3WILDERCAR/Proyecto_Micro/README.md

# Proyecto_Micro
Aqui se va a subir todo lo que se vaya a programar
