3WILDERCAR/Proyecto_Micro/Archivos KiCAD/Green_Card.kicad_sch

## KiCad design Archivos KiCAD/Green_Card.kicad_sch (2026-10-22)

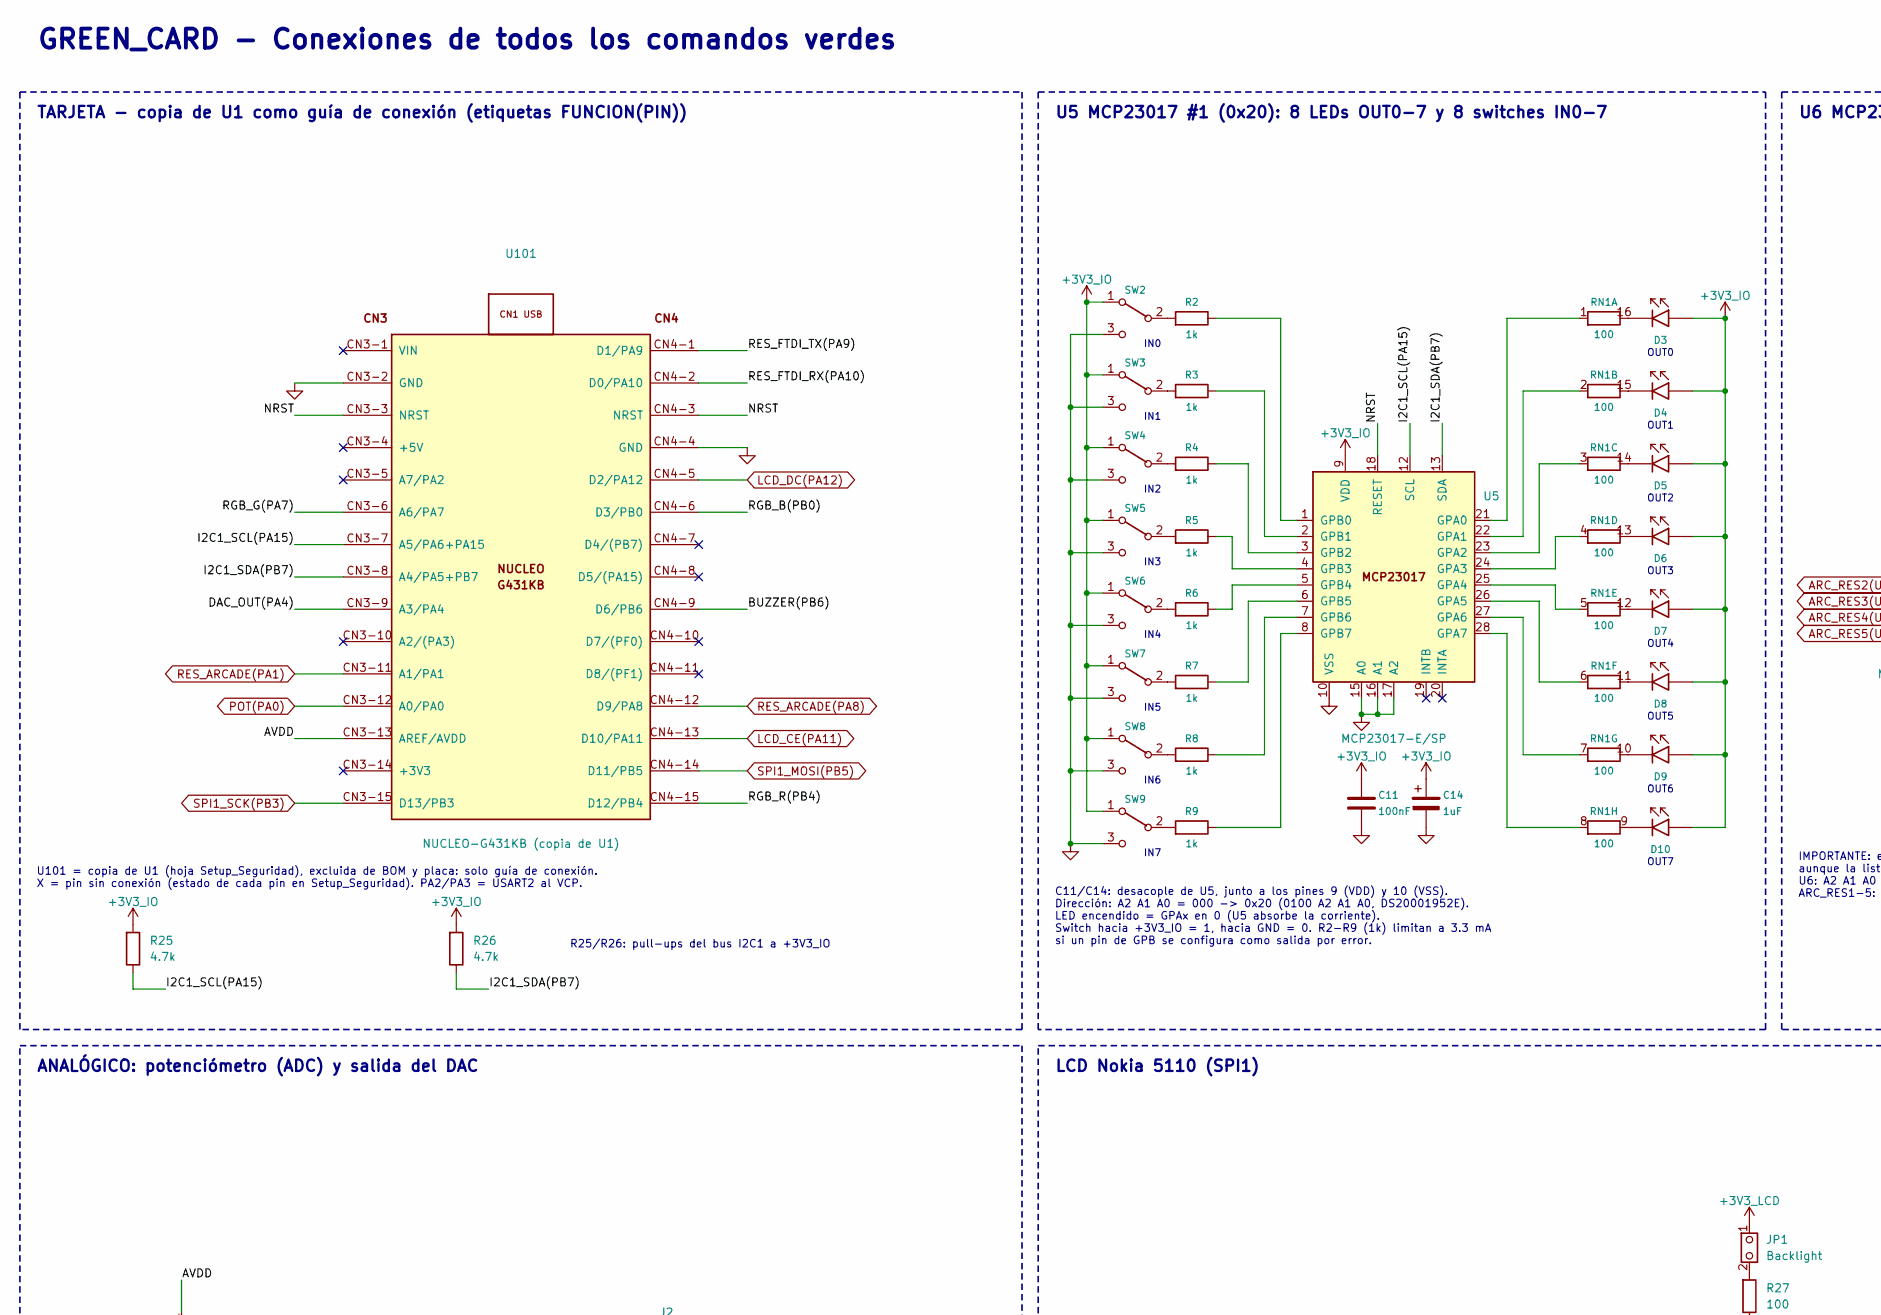
[picture p1: schematic Green_Card.kicad_sch, part in row 1, column 1]

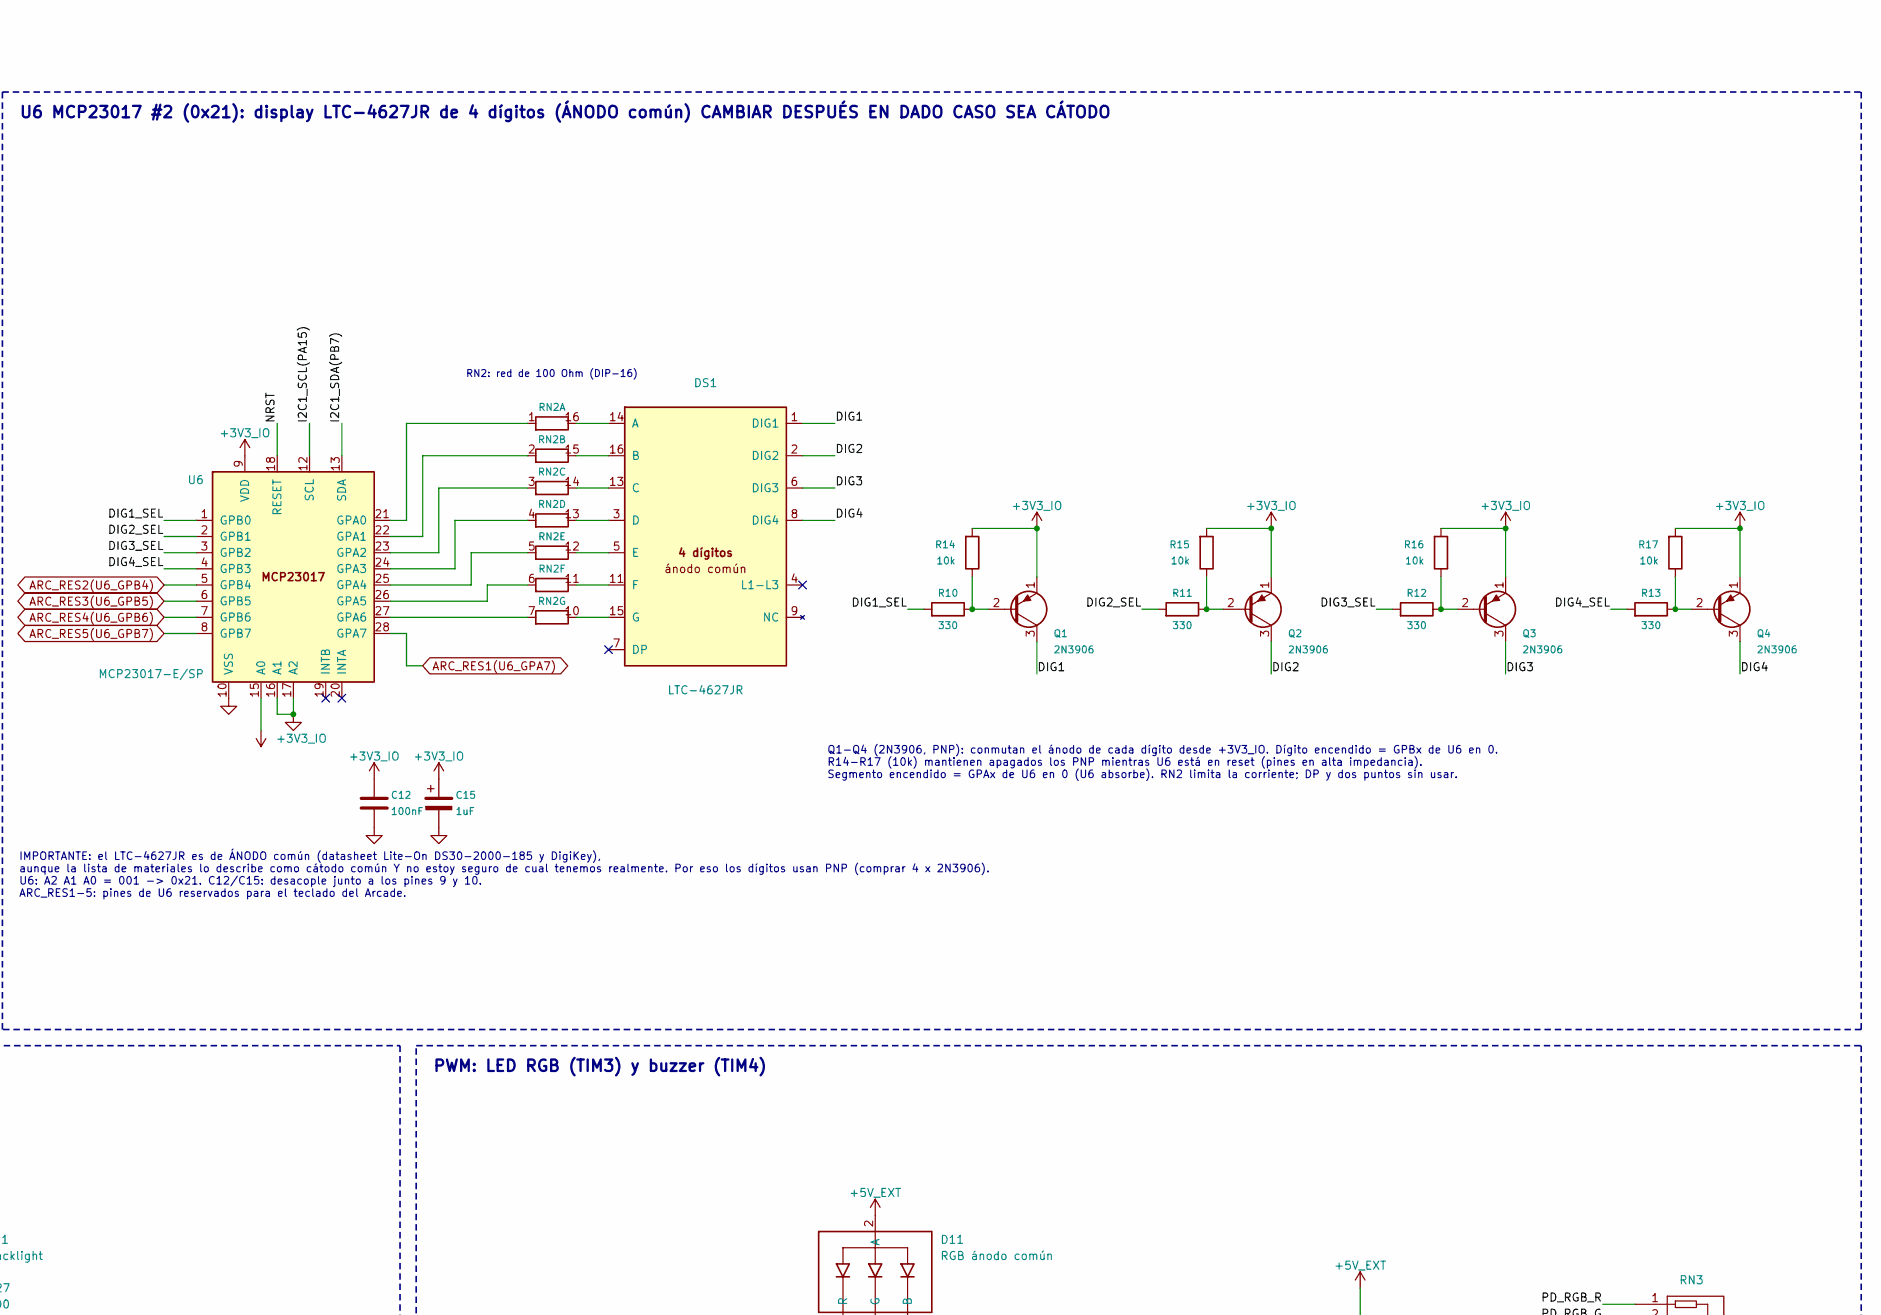
[picture p2: schematic Green_Card.kicad_sch, part in row 1, column 2]

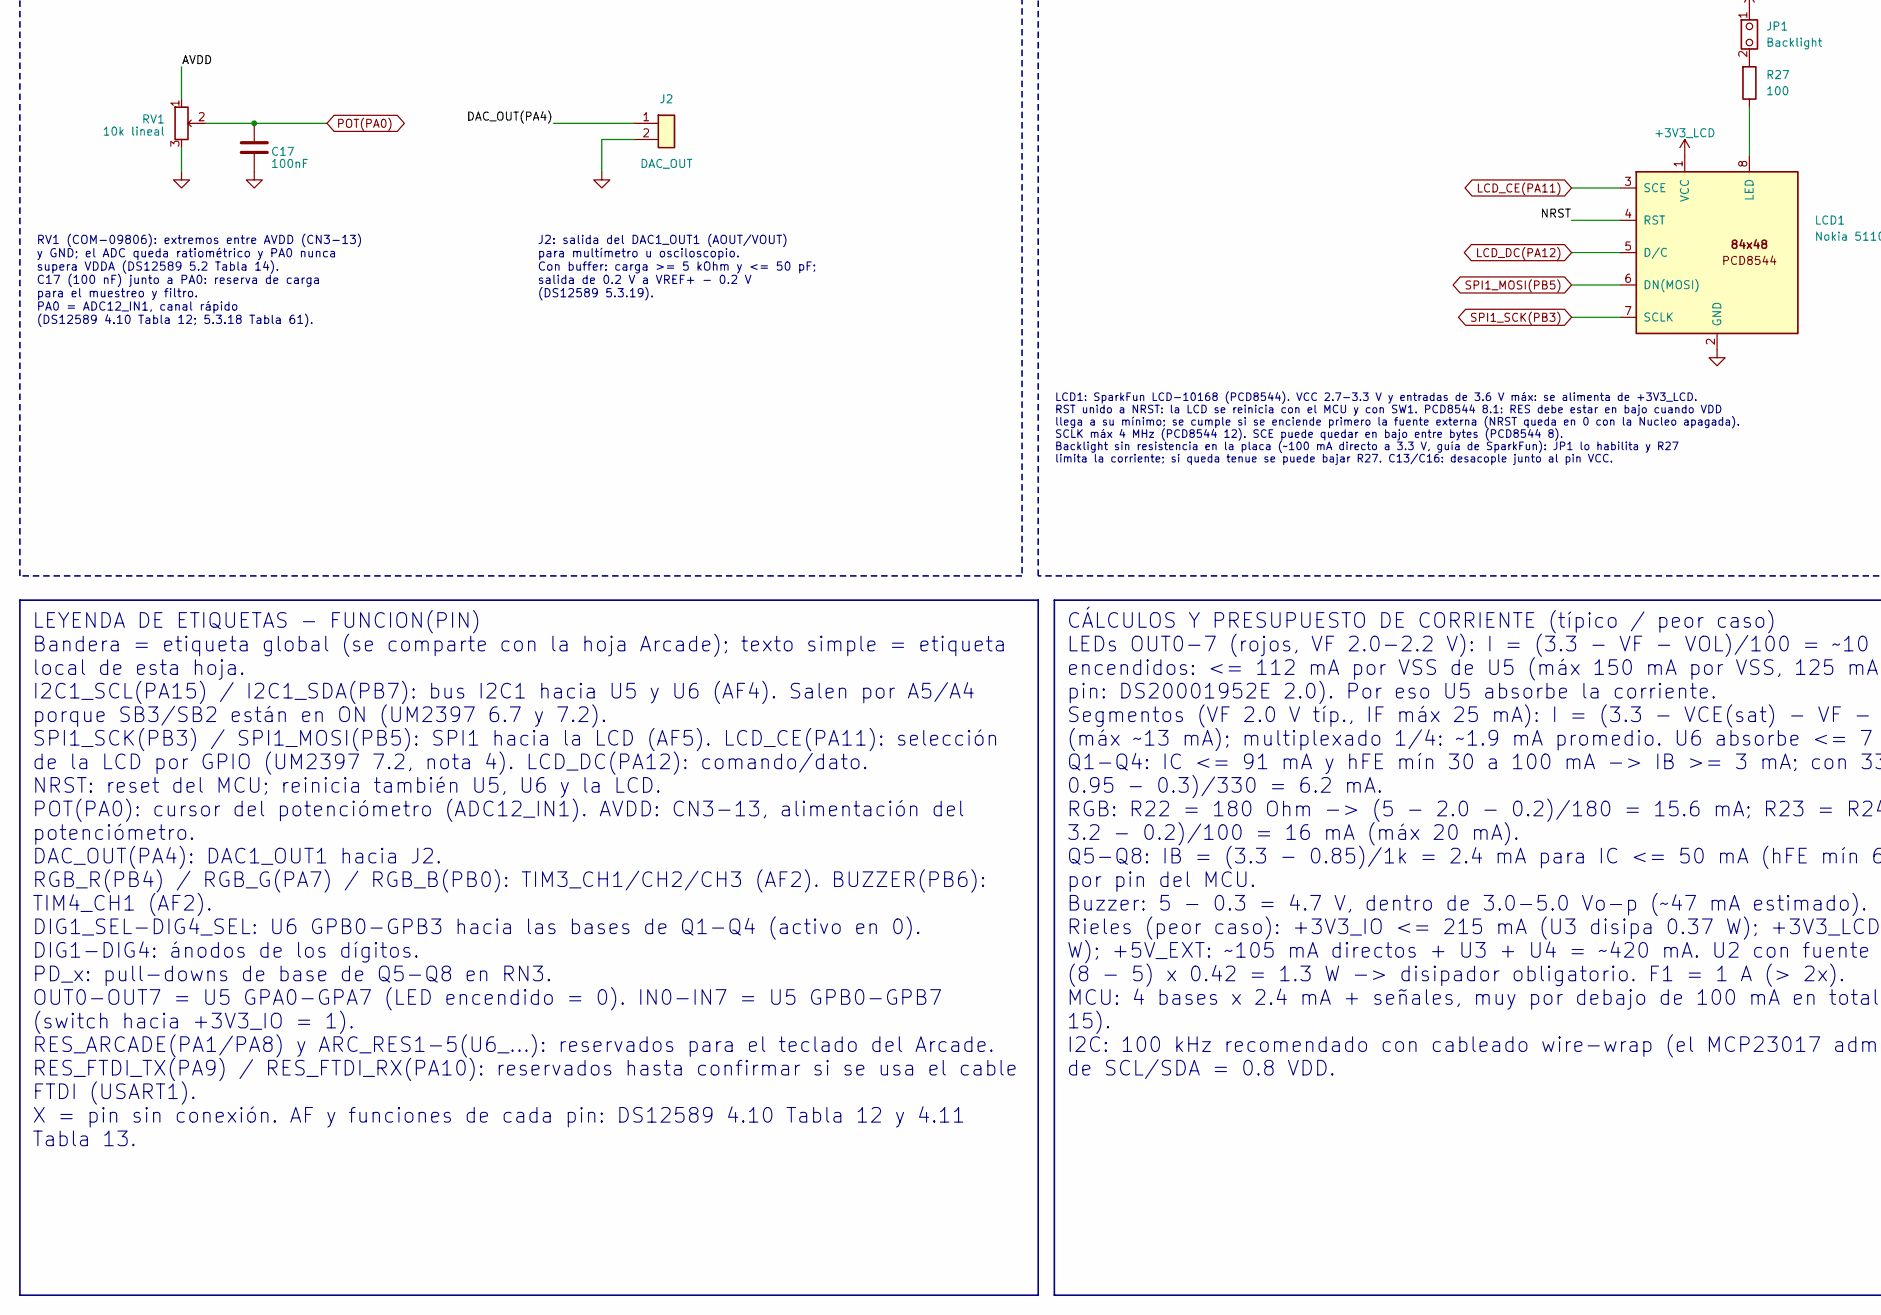
[picture p3: schematic Green_Card.kicad_sch, part in row 2, column 1]

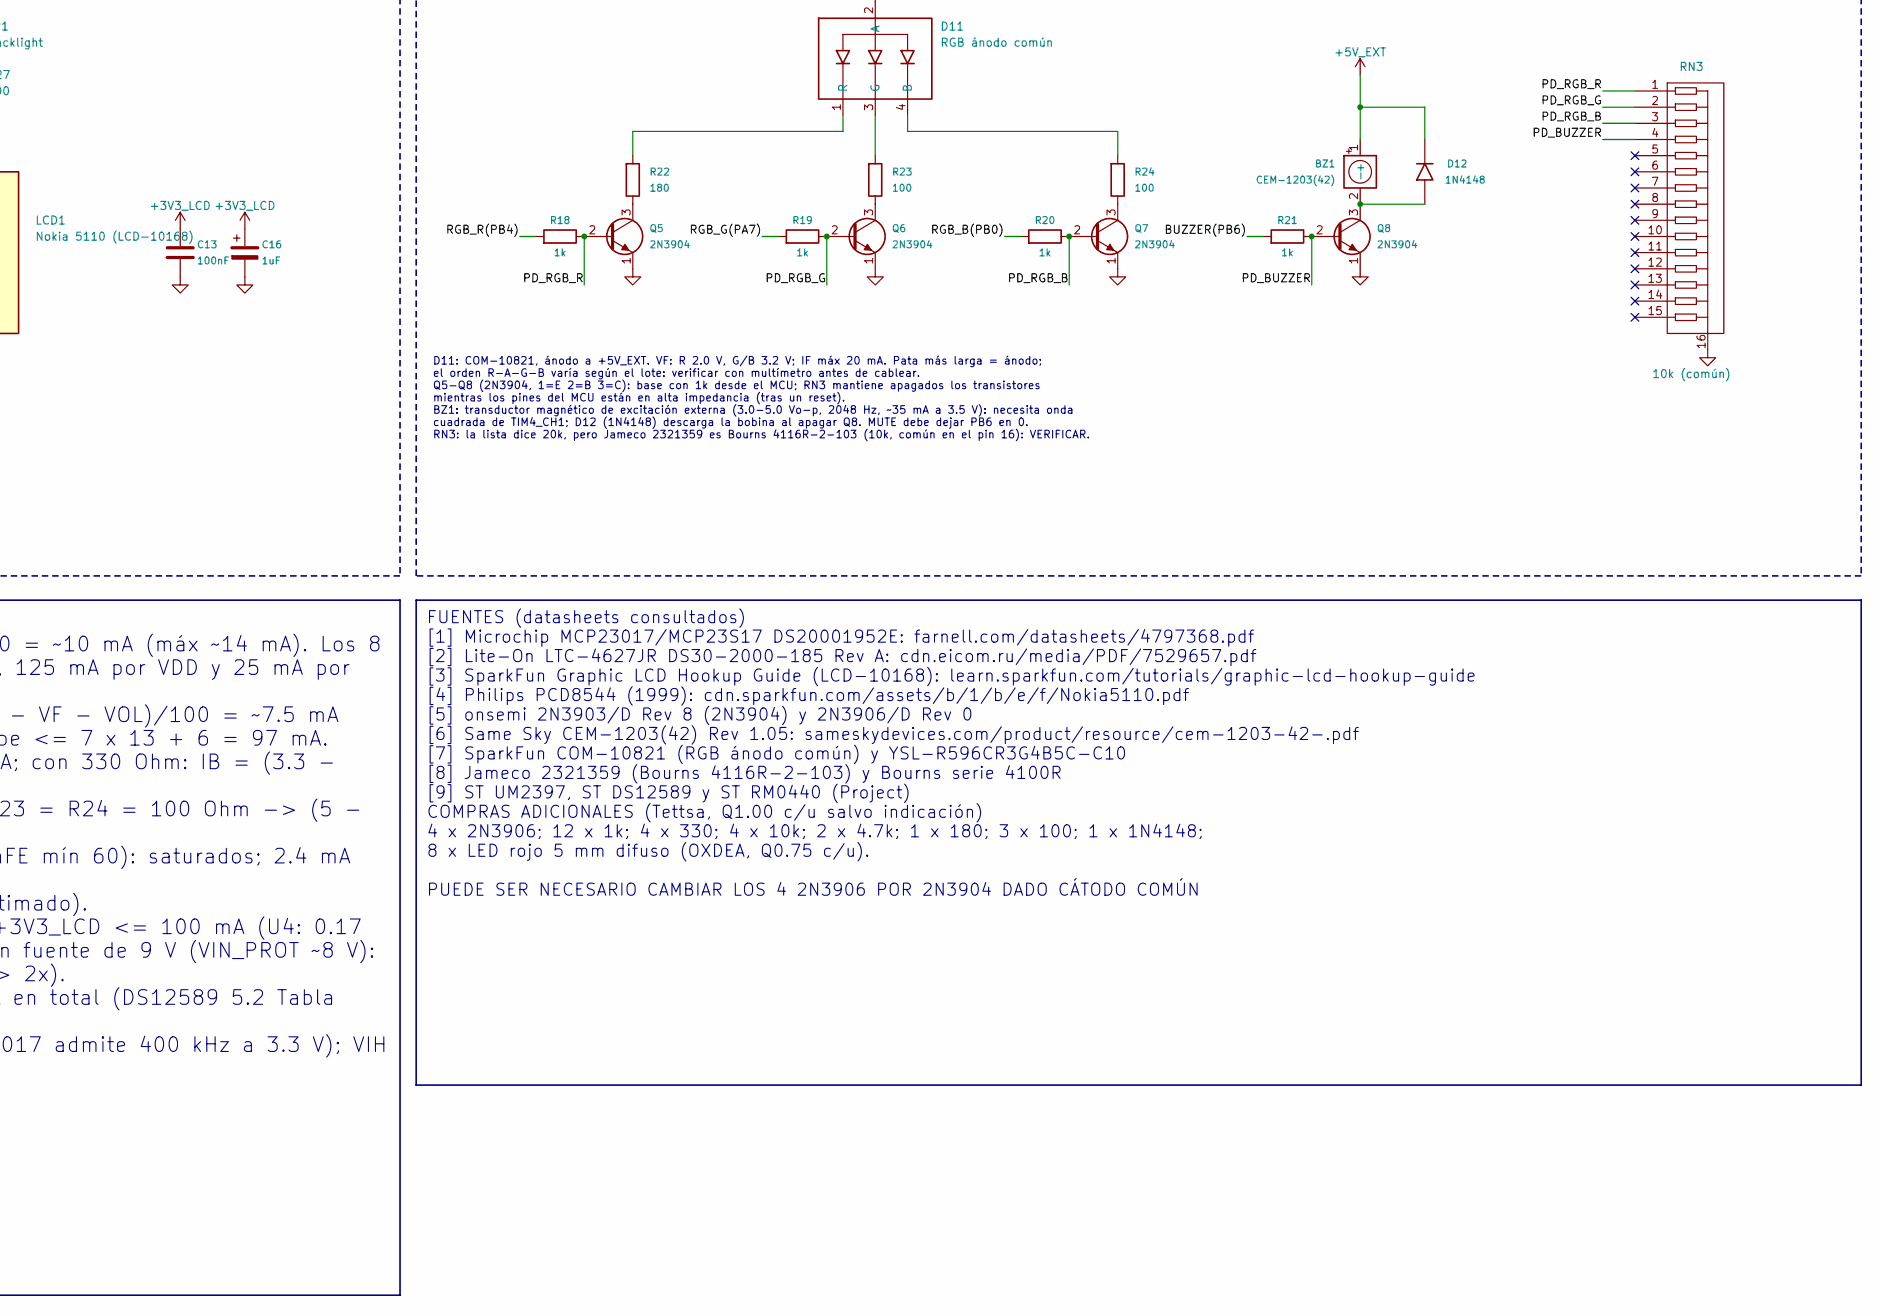
[picture p4: schematic Green_Card.kicad_sch, part in row 2, column 2]

Parts:
BZ1: CEM-1203(42)
C11, C12, C13, C17: 100nF
C14, C15, C16: 1uF
D3, D4, D5, D6, D7, D8, D9, D10: Rojo 5mm
D11: RGB ánodo común
D12: 1N4148
DS1: LTC-4627JR
J2: DAC_OUT
JP1: Backlight
LCD1: Nokia 5110 (LCD-10168)
Q1, Q2, Q3, Q4: 2N3906
Q5, Q6, Q7, Q8: 2N3904
R2, R3, R4, R5, R6, R7, R8, R9, R18, R19, R20, R21: 1k
R10, R11, R12, R13: 330
R14, R15, R16, R17: 10k
R22: 180
R23, R24, R27: 100
R25, R26: 4.7k
RN1, RN2: 100
RN3: 10k (común)
RV1: 10k lineal
SW2, SW3, SW4, SW5, SW6, SW7, SW8, SW9: SPDT
U5, U6: MCP23017-E/SP
U101: NUCLEO-G431KB (copia de U1)

Connections:
+3V3_IO: C11.1, C12.1, C14.1 (+), C15.1 (+), D3.2 (A), D4.2 (A), D5.2 (A), D6.2 (A), D7.2 (A), D8.2 (A), D9.2 (A), D10.2 (A), Q1.1 (E), Q2.1 (E), Q3.1 (E), Q4.1 (E), R14.1, R15.1, R16.1, R17.1, R25.1, R26.1, SW2.1, SW3.1, SW4.1, SW5.1, SW6.1, SW7.1, SW8.1, SW9.1, U5.9 (VDD), U6.9 (VDD), U6.15 (A0)
+3V3_LCD: C13.1, C16.1 (+), JP1.1, LCD1.1 (VCC)
+5V_EXT: BZ1.1 (+), D11.2 (A), D12.1 (K)
ARC_RES1(U6_GPA7): U6.28 (GPA7)
ARC_RES2(U6_GPB4): U6.5 (GPB4)
ARC_RES3(U6_GPB5): U6.6 (GPB5)
ARC_RES4(U6_GPB6): U6.7 (GPB6)
ARC_RES5(U6_GPB7): U6.8 (GPB7)
AVDD: RV1.1, U101.CN3-13 (AREF/AVDD)
BUZZER(PB6): R21.1, U101.CN4-9 (D6/PB6)
DAC_OUT(PA4): J2.1, U101.CN3-9 (A3/PA4)
DIG1: DS1.1 (DIG1), Q1.3 (C)
DIG1_SEL: R10.1, U6.1 (GPB0)
DIG2: DS1.2 (DIG2), Q2.3 (C)
DIG2_SEL: R11.1, U6.2 (GPB1)
DIG3: DS1.6 (DIG3), Q3.3 (C)
DIG3_SEL: R12.1, U6.3 (GPB2)
DIG4: DS1.8 (DIG4), Q4.3 (C)
DIG4_SEL: R13.1, U6.4 (GPB3)
GND: C11.2, C12.2, C13.2, C14.2 (-), C15.2 (-), C16.2 (-), C17.2, J2.2, LCD1.2 (GND), Q5.1 (E), Q6.1 (E), Q7.1 (E), Q8.1 (E), RN3.16 (COM), RV1.3, SW2.3, SW3.3, SW4.3, SW5.3, SW6.3, SW7.3, SW8.3, SW9.3, U5.10 (VSS), U5.15 (A0), U5.16 (A1), U5.17 (A2), U6.10 (VSS), U6.16 (A1), U6.17 (A2), U101.CN3-2 (GND), U101.CN4-4 (GND)
I2C1_SCL(PA15): R25.2, U5.12 (SCL), U6.12 (SCL), U101.CN3-7 (A5/PA6+PA15)
I2C1_SDA(PB7): R26.2, U5.13 (SDA), U6.13 (SDA), U101.CN3-8 (A4/PA5+PB7)
LCD_CE(PA11): LCD1.3 (SCE), U101.CN4-13 (D10/PA11)
LCD_DC(PA12): LCD1.5 (D/C), U101.CN4-5 (D2/PA12)
NRST: LCD1.4 (RST), U5.18 (RESET), U6.18 (RESET), U101.CN3-3 (NRST), U101.CN4-3 (NRST)
unnamed: BZ1.2 (-), D12.2 (A), Q8.3 (C)
unnamed: D3.1 (K), RN1.16
unnamed: D4.1 (K), RN1.15
unnamed: D5.1 (K), RN1.14
unnamed: D6.1 (K), RN1.13
unnamed: D7.1 (K), RN1.12
unnamed: D8.1 (K), RN1.11
unnamed: D9.1 (K), RN1.10
unnamed: D10.1 (K), RN1.9
unnamed: D11.1 (R), R22.1
unnamed: D11.3 (G), R23.1
unnamed: D11.4 (B), R24.1
unnamed: DS1.3 (D), RN2.13
unnamed: DS1.5 (E), RN2.12
unnamed: DS1.11 (F), RN2.11
unnamed: DS1.13 (C), RN2.14
unnamed: DS1.14 (A), RN2.16
unnamed: DS1.15 (G), RN2.10
unnamed: DS1.16 (B), RN2.15
unnamed: JP1.2, R27.1
unnamed: LCD1.8 (LED), R27.2
unnamed: Q1.2 (B), R10.2, R14.2
unnamed: Q2.2 (B), R11.2, R15.2
unnamed: Q3.2 (B), R12.2, R16.2
unnamed: Q4.2 (B), R13.2, R17.2
unnamed: Q5.3 (C), R22.2
unnamed: Q6.3 (C), R23.2
unnamed: Q7.3 (C), R24.2
unnamed: R2.1, SW2.2
unnamed: R2.2, U5.1 (GPB0)
unnamed: R3.1, SW3.2
unnamed: R3.2, U5.2 (GPB1)
unnamed: R4.1, SW4.2
unnamed: R4.2, U5.3 (GPB2)
unnamed: R5.1, SW5.2
unnamed: R5.2, U5.4 (GPB3)
unnamed: R6.1, SW6.2
unnamed: R6.2, U5.5 (GPB4)
unnamed: R7.1, SW7.2
unnamed: R7.2, U5.6 (GPB5)
unnamed: R8.1, SW8.2
unnamed: R8.2, U5.7 (GPB6)
unnamed: R9.1, SW9.2
unnamed: R9.2, U5.8 (GPB7)
unnamed: RN1.1, U5.21 (GPA0)
unnamed: RN1.2, U5.22 (GPA1)
unnamed: RN1.3, U5.23 (GPA2)
unnamed: RN1.4, U5.24 (GPA3)
unnamed: RN1.5, U5.25 (GPA4)
unnamed: RN1.6, U5.26 (GPA5)
unnamed: RN1.7, U5.27 (GPA6)
unnamed: RN1.8, U5.28 (GPA7)
unnamed: RN2.1, U6.21 (GPA0)
unnamed: RN2.2, U6.22 (GPA1)
unnamed: RN2.3, U6.23 (GPA2)
unnamed: RN2.4, U6.24 (GPA3)
unnamed: RN2.5, U6.25 (GPA4)
unnamed: RN2.6, U6.26 (GPA5)
unnamed: RN2.7, U6.27 (GPA6)
PD_BUZZER: Q8.2 (B), R21.2, RN3.4
PD_RGB_B: Q7.2 (B), R20.2, RN3.3
PD_RGB_G: Q6.2 (B), R19.2, RN3.2
PD_RGB_R: Q5.2 (B), R18.2, RN3.1
POT(PA0): C17.1, RV1.2, U101.CN3-12 (A0/PA0)
RES_ARCADE(PA1): U101.CN3-11 (A1/PA1)
RES_ARCADE(PA8): U101.CN4-12 (D9/PA8)
RES_FTDI_RX(PA10): U101.CN4-2 (D0/PA10)
RES_FTDI_TX(PA9): U101.CN4-1 (D1/PA9)
RGB_B(PB0): R20.1, U101.CN4-6 (D3/PB0)
RGB_G(PA7): R19.1, U101.CN3-6 (A6/PA7)
RGB_R(PB4): R18.1, U101.CN4-15 (D12/PB4)
SPI1_MOSI(PB5): LCD1.6 (DN(MOSI)), U101.CN4-14 (D11/PB5)
SPI1_SCK(PB3): LCD1.7 (SCLK), U101.CN3-15 (D13/PB3)

Notes on the sheet:
GREEN_CARD - Conexiones de todos los comandos verdes
IN4
IN2
C11/C14: desacople de U5, junto a los pines 9 (VDD) y 10 (VSS). Dirección: A2 A1 A0 = 000 -> 0x20 (0100 A2 A1 A0, DS20001952E). LED encendido = GPAx en 0 (U5 absorbe la corriente). Switch hacia +3V3_IO = 1, hacia GND = 0. R2-R9 (1k) limitan a 3.3 mA si un pin de GPB se configura como salida por err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
U6 MCP23017 #2 (0x21): display LTC-4627JR de 4 dígitos (ÁNODO común) CAMBIAR DESPUÉS EN DADO CASO SEA CÁTODO
RN2: red de 100 Ohm (DIP-16)
OUT6
Q1-Q4 (2N3906, PNP): conmutan el ánodo de cada dígito desde +3V3_IO. Dígito encendido = GPBx de U6 en 0. R14-R17 (10k) mantienen apagados los PNP mientras U6 está en reset (pines en alta impedancia). Segmento encendido = GPAx de U6 en 0 (U6 absorbe). RN2 limita la corriente; DP y dos puntos sin usa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
IN1
U5 MCP23017 #1 (0x20): 8 LEDs OUT0-7 y 8 switches IN0-7
IMPORTANTE: el LTC-4627JR es de ÁNODO común (datasheet Lite-On DS30-2000-185 y DigiKey), aunque la lista de materiales lo describe como cátodo común Y no estoy seguro de cual tenemos realmente. Por eso los dígitos usan PNP (comprar 4 x 2N3906). U6: A2 A1 A0 = 001 -> 0x21. C12/C15: desacople junto a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
IN6
RV1 (COM-09806): extremos entre AVDD (CN3-13) y GND; el ADC queda ratiométrico y PA0 nunca supera VDDA (DS12589 5.2 Tabla 14). C17 (100 nF) junto a PA0: reserva de carga para el muestreo y filtro. PA0 = ADC12_IN1, canal rápido (DS12589 4.10 Tabla 12; 5.3.18 Tabla 61).
D11: COM-10821, ánodo a +5V_EXT. VF: R 2.0 V, G/B 3.2 V; IF máx 20 mA. Pata más larga = ánodo; el orden R-A-G-B varía según el lote: verificar con multímetro antes de cablear. Q5-Q8 (2N3904, 1=E 2=B 3=C): base con 1k desde el MCU; RN3 mantiene apagados los transistores mientras los pines del MCU es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
OUT5
LCD1: SparkFun LCD-10168 (PCD8544). VCC 2.7-3.3 V y entradas de 3.6 V máx: se alimenta de +3V3_LCD. RST unido a NRST: la LCD se reinicia con el MCU y con SW1. PCD8544 8.1: RES debe estar en bajo cuando VDD llega a su mínimo; se cumple si se enciende primero la fuente externa (NRST queda en 0 con la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
R25/R26: pull-ups del bus I2C1 a +3V3_IO
PWM: LED RGB (TIM3) y buzzer (TIM4)
U101 = copia de U1 (hoja Setup_Seguridad), excluida de BOM y placa: solo guía de conexión. X = pin sin conexión (estado de cada pin en Setup_Seguridad). PA2/PA3 = USART2 al VCP.
OUT4
OUT2
IN0
J2: salida del DAC1_OUT1 (AOUT/VOUT) para multímetro u osciloscopio. Con buffer: carga >= 5 kOhm y <= 50 pF; salida de 0.2 V a VREF+ - 0.2 V (DS12589 5.3.19).
OUT3
OUT1
IN7
OUT0
TARJETA - copia de U1 como guía de conexión (etiquetas FUNCION(PIN))
IN5
IN3
ANALÓGICO: potenciómetro (ADC) y salida del DAC
LCD Nokia 5110 (SPI1)
OUT7
CÁLCULOS Y PRESUPUESTO DE CORRIENTE (típico / peor caso) LEDs OUT0-7 (rojos, VF 2.0-2.2 V): I = (3.3 - VF - VOL)/100 = ~10 mA (máx ~14 mA). Los 8 encendidos: <= 112 mA por VSS de U5 (máx 150 mA por VSS, 125 mA por VDD y 25 mA por pin: DS20001952E 2.0). Por eso U5 absorbe la corriente. Segmentos (VF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
LEYENDA DE ETIQUETAS - FUNCION(PIN) Bandera = etiqueta global (se comparte con la hoja Arcade); texto simple = etiqueta local de esta hoja. I2C1_SCL(PA15) / I2C1_SDA(PB7): bus I2C1 hacia U5 y U6 (AF4). Salen por A5/A4 porque SB3/SB2 están en ON (UM2397 6.7 y 7.2). SPI1_SCK(PB3) / SPI1_MOSI(PB5): SP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
FUENTES (datasheets consultados) [1] Microchip MCP23017/MCP23S17 DS20001952E: farnell.com/datasheets/4797368.pdf [2] Lite-On LTC-4627JR DS30-2000-185 Rev A: cdn.eicom.ru/media/PDF/7529657.pdf [3] SparkFun Graphic LCD Hookup Guide (LCD-10168): learn.sparkfun.com/tutorials/graphic-lcd-hookup-guide [4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
