3WILDERCAR/Proyecto_Micro/Archivos KiCAD/Setup_Seguridad.kicad_sch

## KiCad design Archivos KiCAD/Setup_Seguridad.kicad_sch (2026-10-22)

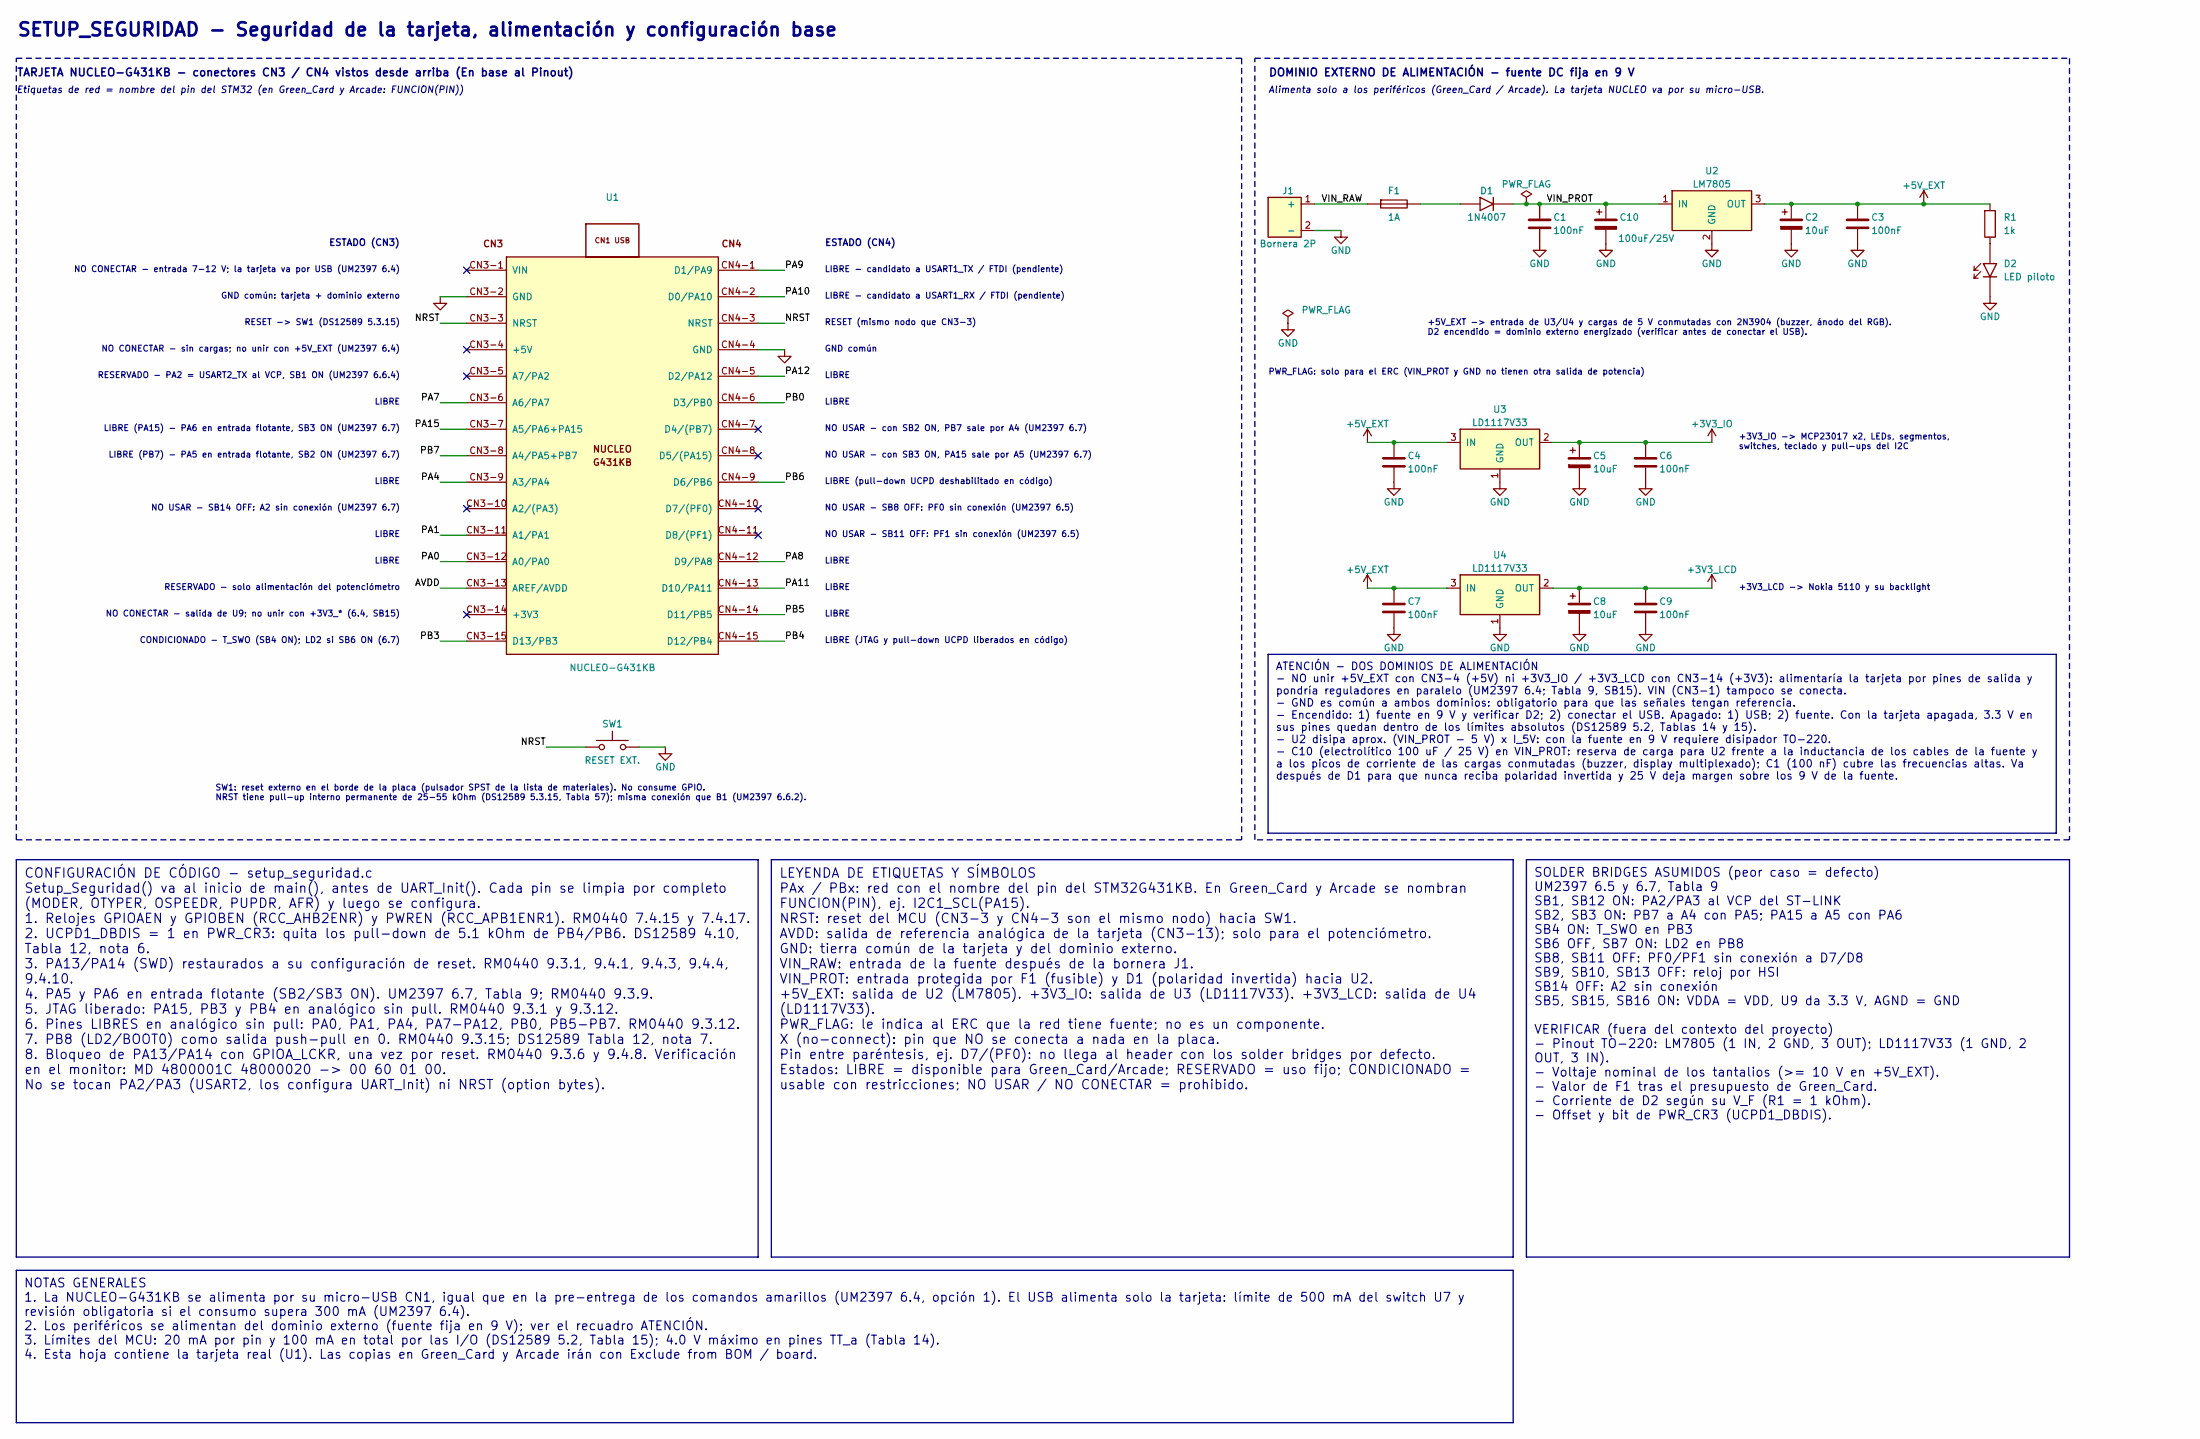
[picture p5: schematic Setup_Seguridad.kicad_sch]

Parts:
C1, C3, C4, C6, C7, C9: 100nF
C2, C5, C8: 10uF
C10: 100uF/25V
D1: 1N4007
D2: LED piloto
F1: 1A
J1: Bornera 2P
R1: 1k
SW1: RESET EXT.
U1: NUCLEO-G431KB
U2: LM7805
U3, U4: LD1117V33

Connections:
+3V3_IO: C5.1 (+), C6.1, U3.2 (OUT)
+3V3_LCD: C8.1 (+), C9.1, U4.2 (OUT)
+5V_EXT: C2.1 (+), C3.1, C4.1, C7.1, R1.1, U2.3 (OUT), U3.3 (IN), U4.3 (IN)
AVDD: U1.CN3-13 (AREF/AVDD)
GND: C1.2, C2.2 (-), C3.2, C4.2, C5.2 (-), C6.2, C7.2, C8.2 (-), C9.2, C10.2 (-), D2.1 (K), J1.2 (-), SW1.2, U1.CN3-2 (GND), U1.CN4-4 (GND), U2.2 (GND), U3.1 (GND), U4.1 (GND)
NRST: SW1.1, U1.CN3-3 (NRST), U1.CN4-3 (NRST)
unnamed: D1.2 (A), F1.2
unnamed: D2.2 (A), R1.2
PA0: U1.CN3-12 (A0/PA0)
PA1: U1.CN3-11 (A1/PA1)
PA4: U1.CN3-9 (A3/PA4)
PA7: U1.CN3-6 (A6/PA7)
PA8: U1.CN4-12 (D9/PA8)
PA9: U1.CN4-1 (D1/PA9)
PA10: U1.CN4-2 (D0/PA10)
PA11: U1.CN4-13 (D10/PA11)
PA12: U1.CN4-5 (D2/PA12)
PA15: U1.CN3-7 (A5/PA6+PA15)
PB0: U1.CN4-6 (D3/PB0)
PB3: U1.CN3-15 (D13/PB3)
PB4: U1.CN4-15 (D12/PB4)
PB5: U1.CN4-14 (D11/PB5)
PB6: U1.CN4-9 (D6/PB6)
PB7: U1.CN3-8 (A4/PA5+PB7)
VIN_PROT: C1.1, C10.1 (+), D1.1 (K), U2.1 (IN)
VIN_RAW: F1.1, J1.1 (+)

Notes on the sheet:
LIBRE - candidato a USART1_TX / FTDI (pendiente)
RESERVADO - solo alimentación del potenciómetro
NO USAR - SB8 OFF: PF0 sin conexión (UM2397 6.5)
RESET (mismo nodo que CN3-3)
+3V3_LCD -> Nokia 5110 y su backlight
LIBRE
NO USAR - con SB2 ON, PB7 sale por A4 (UM2397 6.7)
TARJETA NUCLEO-G431KB - conectores CN3 / CN4 vistos desde arriba (En base al Pinout)
NO USAR - SB11 OFF: PF1 sin conexión (UM2397 6.5)
ESTADO (CN3)
SETUP_SEGURIDAD - Seguridad de la tarjeta, alimentación y configuración base
LIBRE (pull-down UCPD deshabilitado en código)
NO USAR - con SB3 ON, PA15 sale por A5 (UM2397 6.7)
GND común
Etiquetas de red = nombre del pin del STM32 (en Green_Card y Arcade: FUNCION(PIN))
RESERVADO - PA2 = USART2_TX al VCP, SB1 ON (UM2397 6.6.4)
LIBRE (JTAG y pull-down UCPD liberados en código)
LIBRE (PA15) - PA6 en entrada flotante, SB3 ON (UM2397 6.7)
ESTADO (CN4)
SW1: reset externo en el borde de la placa (pulsador SPST de la lista de materiales). No consume GPIO. NRST tiene pull-up interno permanente de 25-55 kOhm (DS12589 5.3.15, Tabla 57); misma conexión que B1 (UM2397 6.6.2).
PWR_FLAG: solo para el ERC (VIN_PROT y GND no tienen otra salida de potencia)
Alimenta solo a los periféricos (Green_Card / Arcade). La tarjeta NUCLEO va por su micro-USB.
NO USAR - SB14 OFF: A2 sin conexión (UM2397 6.7)
+5V_EXT -> entrada de U3/U4 y cargas de 5 V conmutadas con 2N3904 (buzzer, ánodo del RGB). D2 encendido = dominio externo energizado (verificar antes de conectar el USB).
CONDICIONADO - T_SWO (SB4 ON); LD2 si SB6 ON (6.7)
RESET -> SW1 (DS12589 5.3.15)
LIBRE - candidato a USART1_RX / FTDI (pendiente)
+3V3_IO -> MCP23017 x2, LEDs, segmentos, switches, teclado y pull-ups del I2C
NO CONECTAR - sin cargas; no unir con +5V_EXT (UM2397 6.4)
LIBRE (PB7) - PA5 en entrada flotante, SB2 ON (UM2397 6.7)
NO CONECTAR - entrada 7-12 V; la tarjeta va por USB (UM2397 6.4)
NO CONECTAR - salida de U9; no unir con +3V3_* (6.4, SB15)
DOMINIO EXTERNO DE ALIMENTACIÓN - fuente DC fija en 9 V
GND común: tarjeta + dominio externo
CONFIGURACIÓN DE CÓDIGO - setup_seguridad.c Setup_Seguridad() va al inicio de main(), antes de UART_Init(). Cada pin se limpia por completo (MODER, OTYPER, OSPEEDR, PUPDR, AFR) y luego se configura. 1. Relojes GPIOAEN y GPIOBEN (RCC_AHB2ENR) y PWREN (RCC_APB1ENR1). RM0440 7.4.15 y 7.4.17. 2. UCPD1_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
LEYENDA DE ETIQUETAS Y SÍMBOLOS PAx / PBx: red con el nombre del pin del STM32G431KB. En Green_Card y Arcade se nombran FUNCION(PIN), ej. I2C1_SCL(PA15). NRST: reset del MCU (CN3-3 y CN4-3 son el mismo nodo) hacia SW1. AVDD: salida de referencia analógica de la tarjeta (CN3-13); solo para el potenc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
ATENCIÓN - DOS DOMINIOS DE ALIMENTACIÓN - NO unir +5V_EXT con CN3-4 (+5V) ni +3V3_IO / +3V3_LCD con CN3-14 (+3V3): alimentaría la tarjeta por pines de salida y pondría reguladores en paralelo (UM2397 6.4; Tabla 9, SB15). VIN (CN3-1) tampoco se conecta. - GND es común a ambos dominios: obligatorio p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
SOLDER BRIDGES ASUMIDOS (peor caso = defecto) UM2397 6.5 y 6.7, Tabla 9 SB1, SB12 ON: PA2/PA3 al VCP del ST-LINK SB2, SB3 ON: PB7 a A4 con PA5; PA15 a A5 con PA6 SB4 ON: T_SWO en PB3 SB6 OFF, SB7 ON: LD2 en PB8 SB8, SB11 OFF: PF0/PF1 sin conexión a D7/D8 SB9, SB10, SB13 OFF: reloj por HSI SB14 OFF: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
NOTAS GENERALES 1. La NUCLEO-G431KB se alimenta por su micro-USB CN1, igual que en la pre-entrega de los comandos amarillos (UM2397 6.4, opción 1). El USB alimenta solo la tarjeta: límite de 500 mA del switch U7 y revisión obligatoria si el consumo supera 300 mA (UM2397 6.4). 2. Los periféricos se 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
