3WILDERCAR/Proyecto_Micro/(commit log)

2026-10-11 UART subido
2026-10-22 Archivos KiCAD para construccion de proyecto agregados
    [Arcade.kicad_sch, Green_Card.kicad_sch, MicroProject-2026.kicad_sch, Setup_Seguridad.kicad_sch]
2026-10-22 Cambios a manejo de valores y llamada a setup seguridad
2026-10-22 Green Card casi completo
    [Arcade.kicad_sch, Green_Card.kicad_sch, Setup_Seguridad.kicad_sch]
